nttienKID03/self-balancing-bike/README.md

## Design of a PID controller for a self-balancing two-wheeled vertical vehicle
Using PID controller theory and combining it with the MPU6050 sensor, control a two-wheeled vertical vehicle (bicycle model) to move in a self-balancing manner.

My Project: https://youtube.com/shorts/fzjEKal2ZSk

## Overview
This project focuses on  modeling and simulation of a self-balacing bike.  
The mechanical model of the robot was designed in SolidWorks and then integrated into MATLAB/Simulink using Simscape Multibody for dynamic simulation.

## Objectives
- Design a self-balacing bike mechanical structure
- Import the CAD model into MATLAB/Simulink
- Perform kinematic analysis of the robot

## Tools and Software
- SolidWorks – Mechanical design of the robot
- MATLAB – Mathematical modeling and calculations
- Simulink – System modeling and simulation
- Simscape Multibody – Multibody dynamic simulation
