nttienKID03/self-balancing-bike/report/NguyenTanTien.pdf

### BỘ GIÁO DỤC & ĐÀO TẠO

TRƢỜNG ĐẠI HỌC SƢ PHẠM KỸ THUẬT TP. HỒ CHÍ MINH

KHOA ĐIỆN – ĐIỆN TỬ

BỘ MÔN TỰ ĐỘNG ĐIỀU KHIỂN

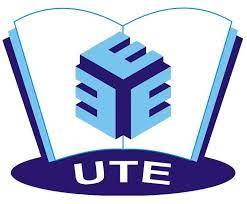
[picture p1: figure]

# BÁO CÁO MÔN HỌC

### Đồ án

### HỆ THỐNG ĐIỀU KHIỂN TỰ ĐỘNG

ĐỀ TÀI:
THIẾT KẾ BỘ ĐIỀU KHIỂN PID CHO XE HAI BÁNH DỌC TỰ CÂN BẰNG

GVHD: PGS. TS. Vũ Văn Phong SVTH: Nguyễn Tấn Tiến

MSSV: 21151171

Tp. Hồ Chí Minh, tháng 01 năm 2025

1

MỤC LỤC

2

3

PHỤ LỤC HÌNH ẢNH

4

PHỤ LỤC BẢNG

5

LỜI CẢM ƠN
Chúng em cũng xin chân thành cảm ơn các thầy cô giáo trong trường Đại

Học Sư Phạm Kỹ Thuật TP Hồ Chí Minh nói chung, các thầy cô trong Ngành

Kỹ Thuật Điều Khiển Và Tự Động Hóa nói riêng đã dạy cho chúng em kiến

thức về các môn đại cương cũng như các môn chuyên ngành, giúp em có đuợc

cơ sở lý thuyết vững vàng và tạo điều kiện giúp đỡ em trong suốt quá trình học

tập và ứng dụng để thực hiện đồ án môn học.

Đặc biệt, chúng em xin gửi lời cảm ơn chân thành đến thầy PGS. TS. Vũ

Văn Phong đã truyền đạt những kiến thức vô cùng hữu ích giúp chúng em hoàn

thành đồ án môn học lý thuyết hệ thống điều khiển tự động nâng cao. Thầy là

người đã luôn theo dõi, hướng dẫn, chỉ bảo rất tận tình những mặt thiếu sót

trong suốt quá trình nhóm thực hiện đề tài.

Trong đề tài chắc chắn sẽ còn nhiều lỗi cần khắc phục, chúng em rất

mong nhận được những đóng góp từ phía thầy và các bạn đọc để sửa chữa và

mở rộng vốn hiểu biết để hoàn thiện hơn cho những đề tài sau.

Sinh viên thực hiện

Nguyễn Tấn Tiến

6

NHẬN XÉT GIẢNG VIÊN

TP.HCM, tháng 01 năm 2025

Giảng viên

7

BỘ GIÁO DỤC VÀ ĐÀO TẠO

TRƢỜNG ĐẠI HỌC SƢ PHẠM KỸ THUẬT

THÀNH PHỐ HỒ CHÍ MINH

KHOA ĐIỆN-ĐIỆN TỬ

CỘNG HÒA XÃ HỘI CHỦ NGHĨA VIỆT NAM

Độc lập - Tự do – Hạnh phúc

DANH SÁCH THÀNH VIÊN THỰC HIỆN BÁO CÁO CUỐI KỲ

MÔN ĐỒ ÁN HỆ THỐNG ĐIỀU KHIỂN TỰ ĐỘNG

HỌC KỲ I NĂM HỌC 2024-2025

### 1. Giảng viên hƣớng dẫn: PGS. TS. Vũ Văn Phong

2. Tên đề tài: Thiết kế bộ điều khiển PID cho mô hình xe hai bánh dọc tự cân bằng.
4. Danh sách nhóm viết báo cáo cuối kỳ:
STT | HỌ VÀ TÊN | MSSV | HOÀN THÀNH | ĐIỂM SỐ
1 | Nguyễn Tấn Tiến | 21151171 | 100%

Nhận xét của giảng viên:

Tháng 01 năm 2025

Ký Tên

8

Chƣơng 1:
TỔNG QUAN

### 1.1. Đặt vấn đề

Trong bối cảnh phát triển mạnh mẽ của khoa học công nghệ, càng nhiều lĩnh vực thay đổi theo hướng hiện đại và tiện nghi. Trong số đó phải kể đến lĩnh vực giao thông. Mô hình xe tự cân bằng ngày càng đóng vai trò quan trọng từ giao thông cá nhân đến nghiên cứu các giải pháp di chuyển. Các bài toán liên quan đến xe hai bánh ngang song song đã được nghiên cứu nhiều và có nhiều thành công, song bài toán xe hai bánh dọc thẳng hàng vẫn còn nhiều hạn chế.

Hệ thống xe hai bánh tự cân bằng là một bài toán thách thức trong lĩnh vực điều khiển và động lực học. Đây là hệ thống có tính phi tuyến cao, chịu ảnh hường của nhiều yếu tố như trọng lực, ma sát,.. Để duy trì trạng thái cân bằng, hệ thống cần tích hợp chặt chẽ các thành phần: cảm biến đo góc nghiêng và gia tốc, thuật toán điều khiển và bộ truyền động. Trong đề tài này, bộ truyền động được nhóm sử dụng là bánh đà phản lực, mô phỏng cơ chế tự cân bằng thông qua chuyển động của cơ thể và tay lái khi con người điêu khiển xe đạp.

Sự độc đáo của xe hai bánh dọc không chỉ nằm ở yêu cầu kỹ thuật cao mà còn ở tiềm năng ứng dụng thực tiễn rộng rãi. Với kích thước nhỏ gọn, tính linh hoạt, xe hai bánh dọc tự cân bằng có thể trở thành giải pháp đột phá cho phương tiện di chuyển cá nhân trong đô thị đông đúc. Hơn nữa, hệ thống này còn là mô hình lý tưởng để nghiên cứu các phương pháp điều khiển hiện đại, áp dụng vào các lĩnh vực như robot tự hành, xe tự lái và các hệ thống tự động hóa thông minh.
Đề tài này sẽ tập trung vào thiết kế bộ điều khiển PID cho hệ phi tuyến xe đạp hai bánh dọc tự cân bằng.

### 1.2. Mục tiêu

- Áp dụng thành công bộ điều khiển PID trên mô hình xe đạp với hai bánh dọc tự cân bằng.

### 1.3. Giới hạn đề tài

- Đề tài tập trung nghiên cứu trên mô hình xe đạp với hai bánh dọc.
- Đề tài tập trung nghiên cứu bộ điều khiển PID cho điều khiển cân bằng.
- Đề tài hướng đến cân bằng hệ xe tại điểm cân bằng và đứng yên tại chỗ.

9

Chƣơng 2:
CƠ SỞ LÝ THUYẾT

### 2.1. Lý thuyết điều khiển PID

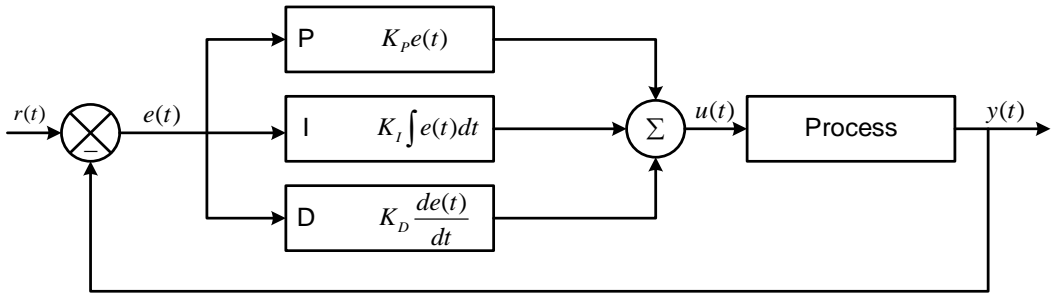
[picture p2: figure]
Process et() -

Hình 1: Cấu trúc bộ điều khiển PID.

Bộ điều khiển vi tích phân tỉ lệ (Proportional Integral Derivative – PID) bao gồm 3 khâu: khâu tỉ lệ (Proportional), khâu tích phân (Integrated) và khâu vi phân (Derivative). PID là một bộ điều khiển đơn giản, được sử dụng nhiều trong thực tế để điều khiển các hệ thống. Bộ điều khiển PID có khả năng điều chỉnh sai số thấp nhất có thể, tăng tốc độ đáp ứng, giảm độ vọt lố, hạn chế sự dao động. Cấu trúc bộ điều khiển PID được trình bày trong Hình 2.1. Có 3 thông số để điều chỉnh tín hiệu điều khiển: KP, KI
, KD
Trong đó, r(t) là giá trị đặt, y(t) là giá trị ngõ ra, giá trị ngõ ra được hồi tiếp về để so sánh với giá trị đặt r(t). Sự sai lệch giữa tín hiệu đặt và ngõ ra gọi là sai số e(t). Sai số được đưa vào bộ điều khiển PID sau đó xuất ra tín hiệu điều khiển u(t) điều khiển hệ thống Process.

0

( ) | ( ) | ( ) | ( )
| | t
p | I | D

d
u t | K e t | K e t dt K | e t
dt
= | + | + ò
(1)

Các thông số KP, KI

, KD là các thông số của bộ điều khiển PID. Nếu thông số này được lựa chọn phù hợp thì hệ thống sẽ hoạt động tốt và chính xác, có nghĩa là độ vọt lố thấp, thời gian xác lập nhanh và sai số xác lập thấp.

### 2.2. Con quay hồi chuyển_bánh xe phản lực

Con quay hồi chuyển là một đĩa quay được sử dụng điều khiển và ổn định các hệ thống như tàu vũ trụ và vệ tinh. Đối với đề tài xe đạp tự cân bằng, con quay hồi chuyển giúp duy trì thăng bằng cho xe. Con quay hồi chuyển có khối lượng tập trung ở viền ngoài của bánh đà, giúp tăng momen quán tính và tạo ra momen xoắn lớn hơn khi quay. Momen xoắn này sẽ phản ứng theo hướng ngược lại, giúp điều chỉnh và ổn định khi xe có xu hướng nghiêng ngã.

10

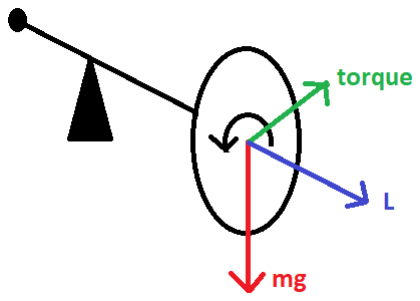
[picture p3: figure]

Hình 2: Mô tả nguyên lý hoạt động của con quay hồi chuyển.

### 2.3. Mô hình hóa hệ thống xe đạp tự cân bằng

### 2.3.1. Chuyển mô hình xe đạp về dạng con lắc ngƣợc

Giới hạn đề tài với xe đứng yên tại chỗ, khi đó trạng thái cân bằng của xe được duy trì thông qua điều khiển góc nghiêng. Mô tả toán học chỉ còn phụ thuộc vào góc nghiêng của xe, ta có mô tả vật lý như sau:

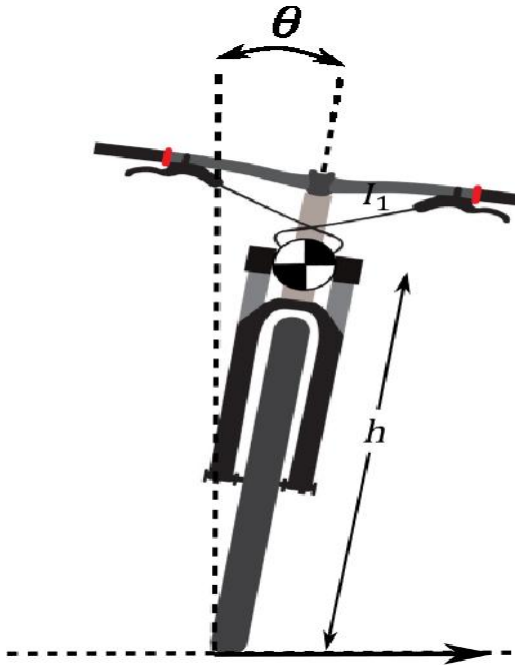
[picture p4: figure]

Hình 3: Mô tả vật lý hệ xe cân bằng đứng yên tại chỗ.

11

Ta thấy sự tương đồng với mô hình hệ con lắc ngược khi xét thân xe trên mặt phẳng thẳng đứng, trọng tâm ở điểm A như hình:

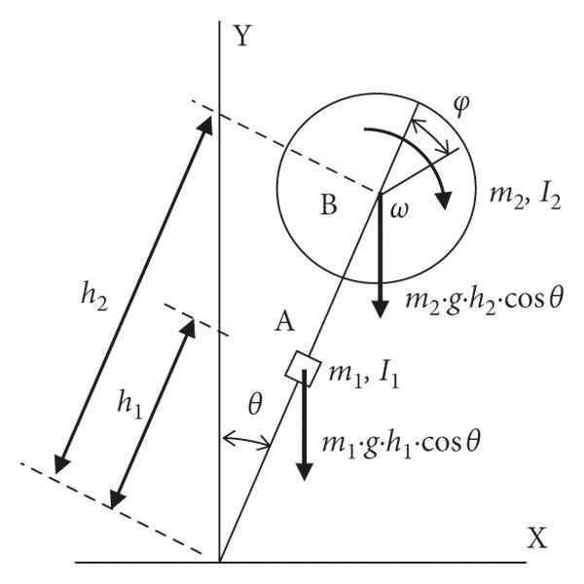
[picture p5: figure]

Hình 4: Chuyển đổi mô hình xe cân bằng về mô hình con lắc ngược.

### 2.3.2. Phân tích vật lý và toán học cho hệ thống

Bảng 2.2.2. Thông số hệ thống

Ký hiệu | Đơn vị | Mô tả
h 1 | m | Khoảng cách từ O đến trọng tâm A của xe.
h 2 | m | Khoảng cách từ O đến điểm đặt B của đĩa phản lực.
m1 | Kg | Khối lượng xe đạp.
m2 | Kg | Khối lượng đĩa phản lực.
θ | Rad | Góc lệch của thân xe đạp so với phương thẳng đứng.
φ | Rad | Góc xoay của đĩa phản lực.

12

I 1 | Kg.m² | Momen quán tính của xe đạp.
I 2 | Kg.m² | Momen quán tính của đĩa phản lực.
g | m/s² | Gia tốc trọng trường.
τ | Nm/A | Momen của động cơ DC.
V | Volt | Điện áp cấp cho động cơ.
K e | m | Hằng số momen động cơ.
Kt | Kg.m² | Hằng số moment xoắn động cơ.
ω m | Rad/s | Tốc độ góc động cơ.
L m | H | Giá trị cảm kháng cuộn cảm động cơ.
R m | Ω | Giá trị điện trở động cơ.
i | A | Dòng điện qua động cơ.

Mô hình toán học của hệ thống được lập từ việc áp dụng phương pháp lượng tử Lagrange:

,( | 1,2) i
i | i
d | L | L | i
dt | q | q

τ

æ | ö ∂ | ∂ ç | ÷ - | = | =
∂ | ∂ è | ø

(2)

Với L là phương trình Lagrange được xác định bởi:
L q q | K q q V q q ( , ) | ( , ) | ( , ) = | -
(3)

Trong đó K là tổng động năng và V là tổng thế năng của hệ.
i

τ

là tổng các lực

liên kết tác động vào hệ thống. Và
[ 1 | 2 ] [ | ]
T | T
q | q | q = | = θφ

là các thành phần liên
kết tạo nên hệ thống.

Ta có:

( | )
2 | 2 | 2 | 2
1 1 | 2 2 | 1 | 2 | 2 | 2
1 | 1
2 | 2
K | m h | m h | I | I | I | I = | + | + | + | + | + θ | θφ | φ

(4)

13

1 1 | 2 2 | 1 1 | 2 2 V | m h m h g | m h m h g = | + | ≈ | + ( | ) cos | ( | ) θ
(5)

Trong đó, xét trường hợp xe ở vị trí cân bằng ( θ

nhỏ vô cùng) thì
cos | 1, sin | . θ | θ θ ≈ | ≈

Qua đó ta tính được phương trình Lagrange như sau:
( | )
2 | 2 | 2 | 2
1 1 | 2 2 | 1 | 2 | 2 | 2 | 1 1 | 2 2
1 | 1 | ( | ) cos
2 | 2
L | m h | m h | I | I | I | I | m h m h g = | + | + + | + | + | - | + θ | θφ | φ | θ
(6)

Từ (2) và (6), suy ra:

2 | 2
1 1 | 2 2 | 1 | 2 | 2 | 1 1 | 2 2
| | | 2
( | ) | ( | ) | 0
( | )
m h | m h | I | I | I | m h | m h g
| | | I
θ | φ | θ
| | | | θ φ τ
ì | + | + | + | + | - | + | = í
î
| | | | + | =

(7)

Viết lại dưới dạng phương trình trạng thái với tín hiệu điều khiển là momen như sau:

2 | 2
0 | 1 0 0 | | 0
/ | 0 0 0 | | 1/
0 | 0 0 1 | | 0
/ | 0 0 0 | ( | ) / ( | )
ba | a
ba | a I | aI
θ | θ
θ | θ
τ
φ | φ
φ | φ
éù é | ù é ù é | ù êú ê | ú ê ú ê | ú
êú = | + ê | ú ê ú ê | ú êú ê | ú ê ú ê | ú êú ê | ú ê ú ê | ú êú ë | û ë û - | ë | û + ëû
(8)

Với:

2 | 2
1 1 | 2 2 | 1 | 1 1 | 2 2 a m h | m h | I | b | m h | m h g = | + | + | = | + , | ( | )

Tiếp theo, ta phân tích động cơ DC:

m | m | e | m
di V L | R i K
dt
= | + | + ω
(9)

Kit
τ =
(10)

Với giá trị cuộn cảm rất nhỏ so với điện trở, ta viết lại công thức (9) như sau:

V | R i K = | +
m | e | m ω
(11)

Ta xem như truyền tải giữa động cơ và bánh xe đạt 100%, khi đó:

ωφ m

=
(12)

Từ (10) , (11) và (12), ta được công thức tính momen động cơ như sau:

( | ) / K V K | R t | e | m τ | φ = | -
(13)

Từ (8) và (13), ta có hệ phương trình mô tả hệ thống như sau:

14

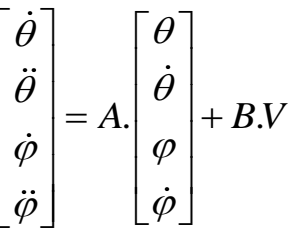
[picture p6: figure]

éù | éù êú | êú êú = | + êú êú | êú êú | êú êú ëû | ëû

(14)

Trong đó:

2 | 2
0 | 1 0 | 0
/ | 0 0 | ( | ) / ( | )
0 | 0 0 | 1
/ | 0 0 | ( | )( | ) / ( | )
t | e | m
t | e | m
b a | K K | aR
A
b a | a I | K K | aI R
é | ù
ê | ú
= ê | ú
ê | ú
ê | ú ë | û - | - + 2 | 2

0
/ ( )
0
( | ) | / ( | )
t | m
t | m
K | aR
B
a I K | aI R
é | ù
ê | ú
= ê | ú
ê | ú
ê | ú ë | û +

Với:

2 | 2
1 1 | 2 2 | 1 | 1 1 | 2 2 a m h | m h | I | b | m h m h g = | + | + | = | + , | ( | )

Các biến trạng thái:

1

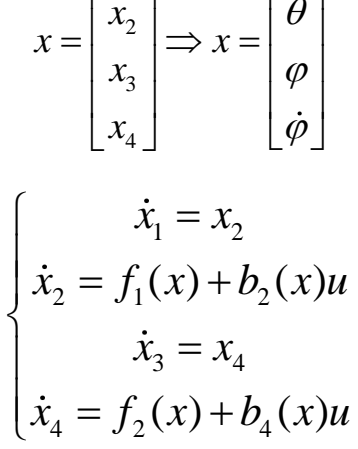
[picture p7: figure]

2

x
x

θ
θ
éù | éù
êú | êú

(15)

(16)

Với:

1 | 21 1 | 24 4 | 2 | 41 1 | 44 4 f x | a x | a x | f x | a x | a x ( ) | , | ( ) = | + | = | +

15

Chƣơng 3:
THIẾT KẾ HỆ THỐNG

### 3.1. Thiết kế mô hình

Một số chi tiết chính như sau:

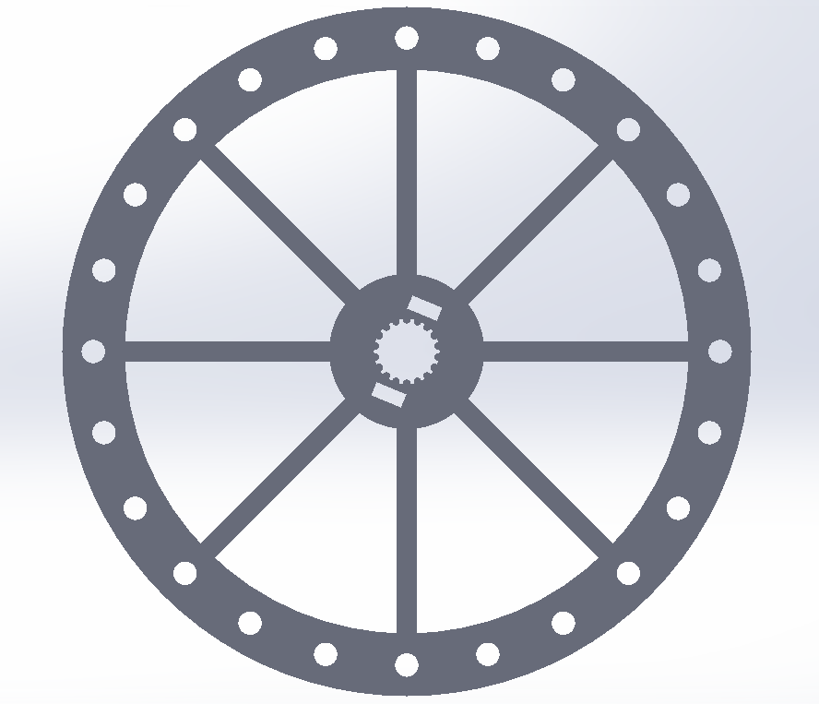
[picture p8: figure]

Hình 5: Bánh đà phản lực thiết kế trên Solidworks.

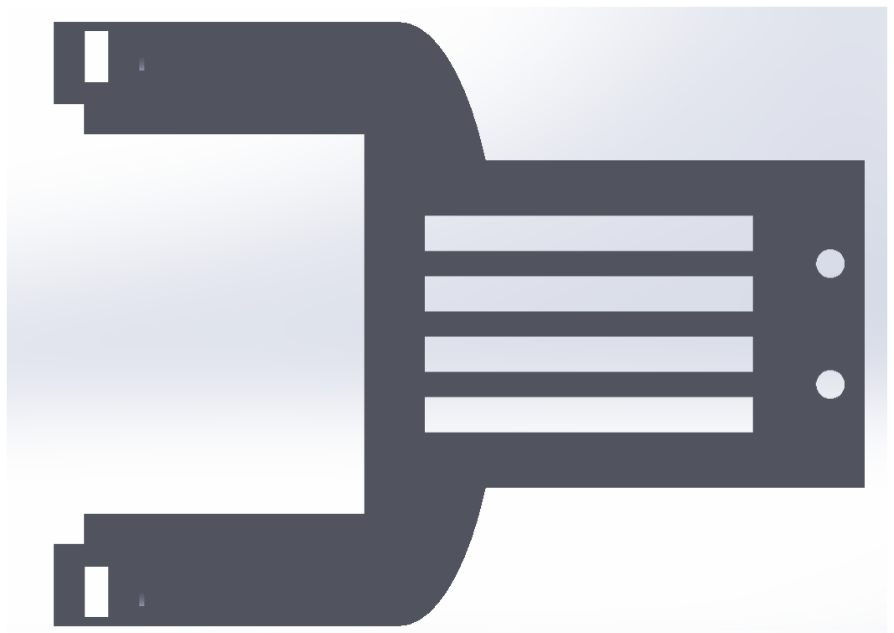
[picture p9: figure]

Hình 6: Phần thân trên.

16

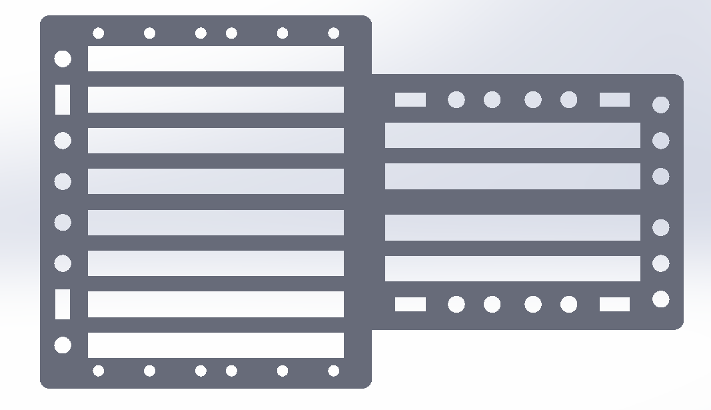
[picture p10: figure]

Hình 7: Phần thân dưới.

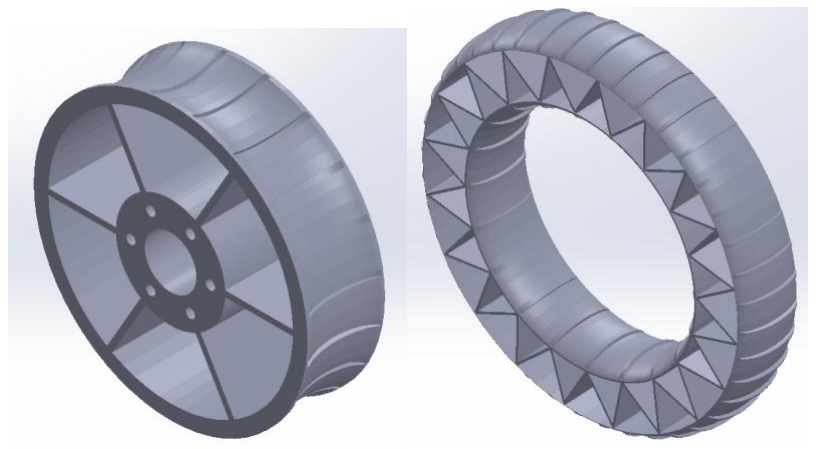
[picture p11: figure]

Hình 8: Bộ bánh sau.

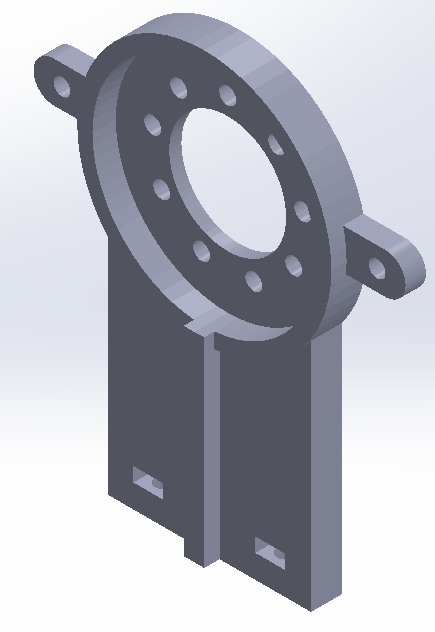
[picture p12: figure]

Hình 9: Trục gắn động cơ.

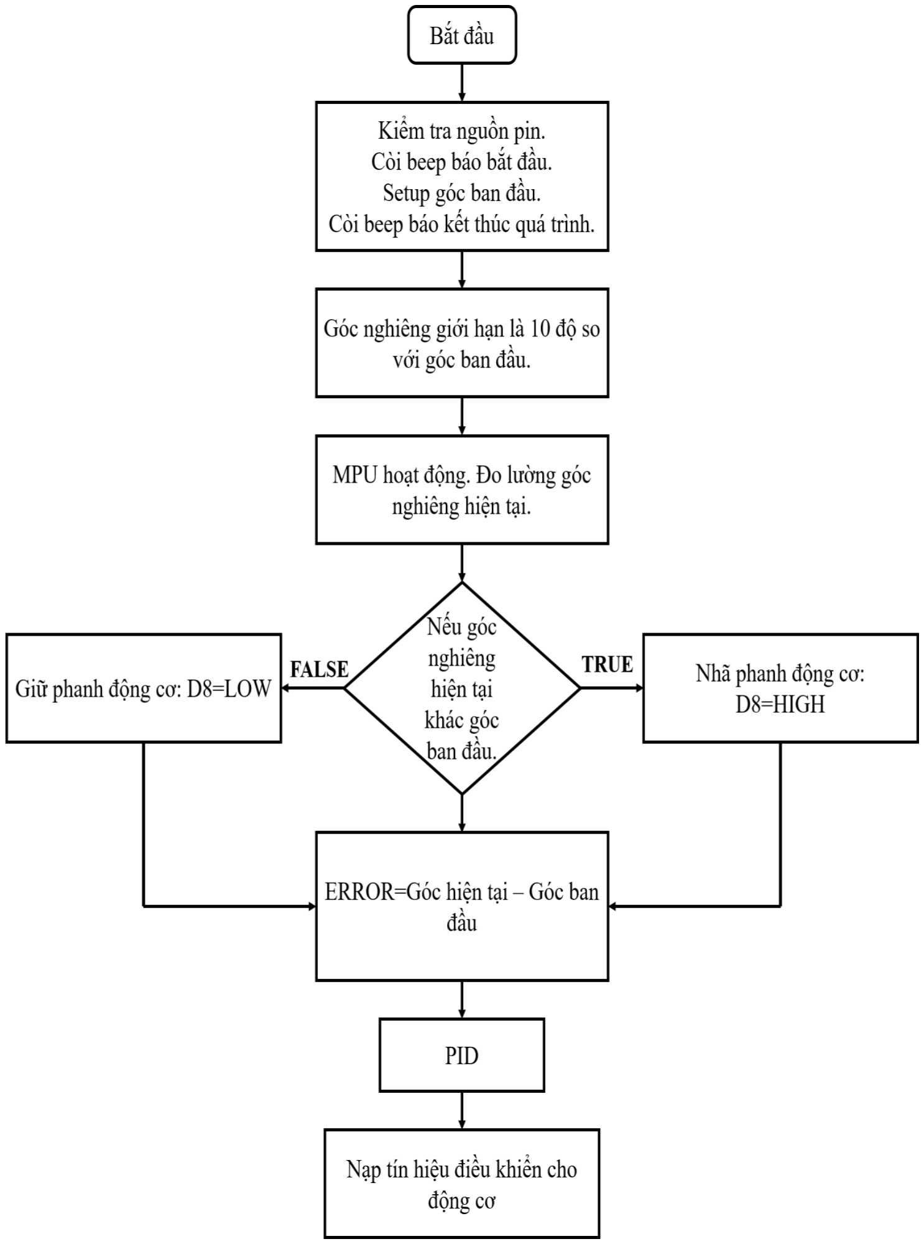
[picture p13: figure]

17

### 3.2. Thiết kế bộ điều khiển

### 3.2.1. Lƣu đồ giải thuật

Hình 10: Lưu đồ giải thuật điều khiển cho hệ xe tự cân bằng.

18

### 3.2.2. Tìm thông số PID bằng MATLAB Simulink

Bảng 3.2.2. Bảng thông số mô phỏng:

Ký hiệu | Đơn vị | Giá trị
h 1 | m | 0.06
h 2 | m | 0.12
m1 | Kg | 1
m2 | Kg | 0.3
I 1 | Kg.m² | 0.0048
I 2 | Kg.m² | 0.00108
g | m/s² | 9.81
K e | m | 0.0649
Kt | Kg.m² | 0.0649
R m | Ω | 5

Ta tiến hành mô phỏng hệ thống:

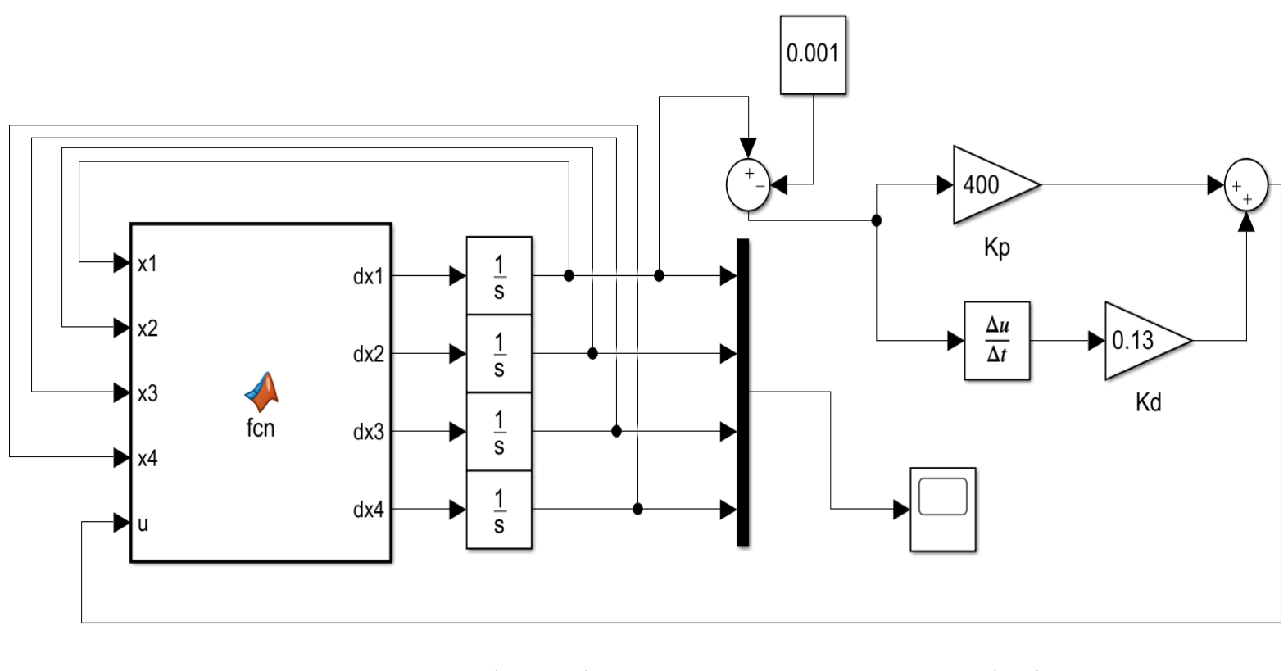
[picture p14: figure]

19

Hình 11: Mô phỏng hệ xe trên MATLAB Simulink.

Chương trình PTVP của hệ thống:

function [dx1,dx2,dx3,dx4] = fcn(x1,x2,x3,x4,u) m1=1;
m2=0.5;
h1=0.06;
h2=0.12;
I1=0.0048;
I2=0.002;
g=9.81;
Ke=0.0649;
Kt=0.0649;
Rm=5;
a=(m1*h1*h1+m2*h2*h2+I1);
b=(m1*h1+m2*h2)*g;
b2=(-Kt)/(a*Rm);
b4=((a+I2)*Kt)/(a*I2*Rm);
dx1=x2;
dx2=b/a*x1+((Kt*Ke)/(a*Rm))*x4+b2*u;
dx3=x4;
dx4=-b/a*x1-(a+I2)*(Kt*Ke)/(a*I2*Rm)*x4+b4*u; end
Ta chọn Kp=15 và Kd=0.13 ngẫu nhiên, thu được kết quả như sau:

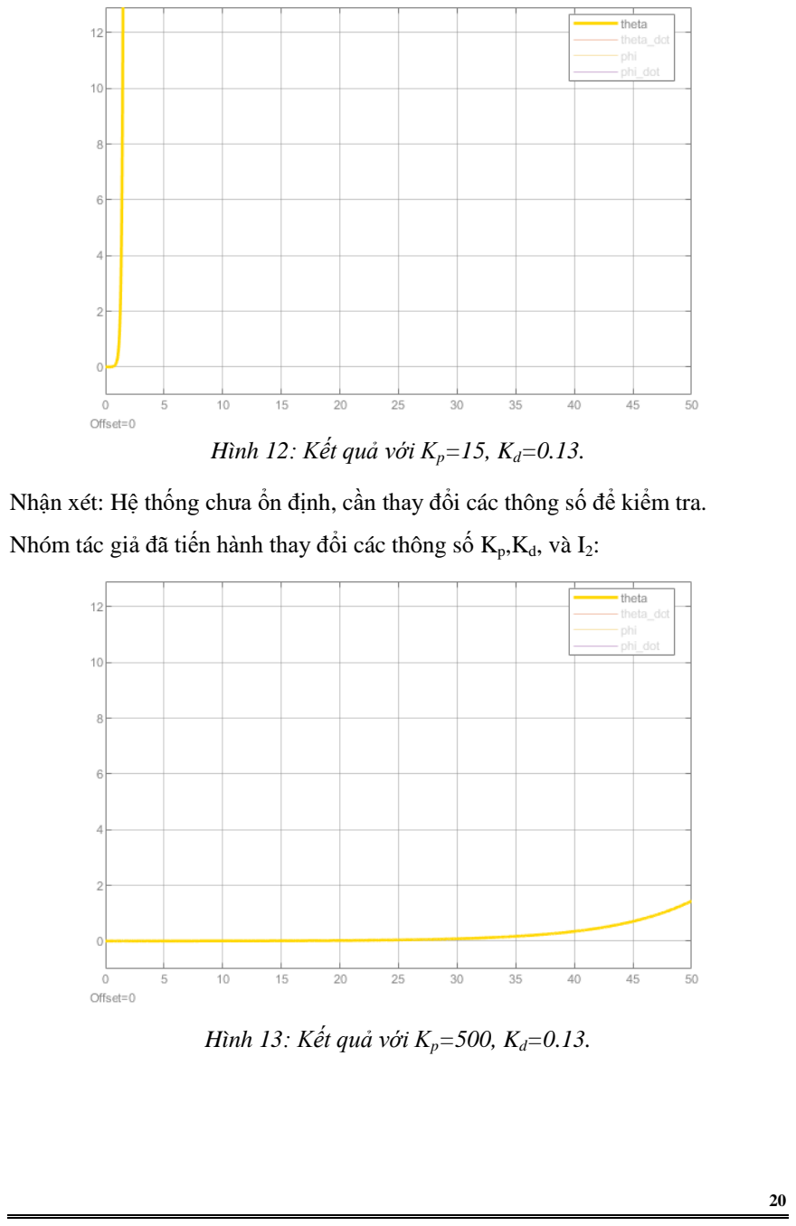
[picture p15: page 21]

20

Hình 12: Kết quả với Kp=15, Kd=0.13.

Nhận xét: Hệ thống chưa ổn định, cần thay đổi các thông số để kiểm tra.

Nhóm tác giả đã tiến hành thay đổi các thông số Kp,Kd, và I2:

Hình 13: Kết quả với Kp=500, Kd=0.13.

21

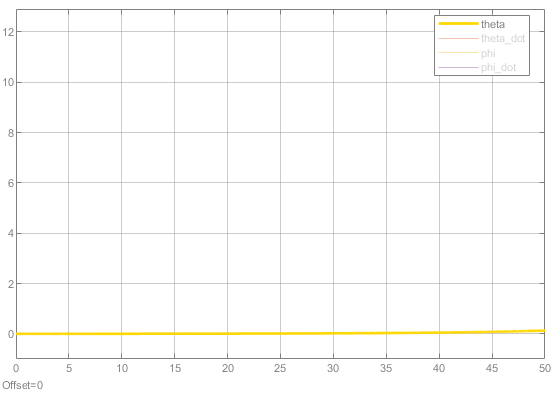
[picture p16: figure]

Hình 14: Kết quả với Kp=500, Kd=0.13, m2=0.5, I2=0.002.

Nhận xét: Cần thử sai nhiều lần với các thông số khác nhau để tìm ra bộ thông số ổn định hệ thống.

Chƣơng 4:
THI CÔNG HỆ THỐNG

### 4.1. Lựa chọn thiết bị

### 4.1.1. Vi điều khiển

- Tến thiết bị: Arduino Uno R3
- Giới thiệu chung: Arduino Uno R3 là một bo mạch vi điều khiển mã nguồn mở thuộc dòng Arduino phổ biến. Sử dụng vi xử lý Atmega328P, nó được thiết kế để đáp ứng nhiều ứng dụng học tập và nghiên cứu khác nhau.
- Lý do lựa chọn: Hệ thống có số lượng đường tín hiệu cảm biến và số lượng tín hiệu điều khiển ít, bên cạnh đó các tác vụ cần xử lý tương đối đơn giản và tốc độ xử lý không cần quá lớn. Do đó nhóm tác giả lựa chọn loại UNO R3 để phục vụ đủ nhu cầu sử dụng và tránh lãng phí.
- Một số thông số kỹ thuật chính:
- Tần số xung nhịp: 16MHz
- Điện áp đầu vào: 7-12V qua jack cấm; 5V qua cổng USB
- Số chân I/O Digital: 14 chân (6 chân PWM)
- Số chân đầu vào Analog: 6 chân

22

- Giao tiếp: UART, SPI, I2C
- Trọng lượng: 25g

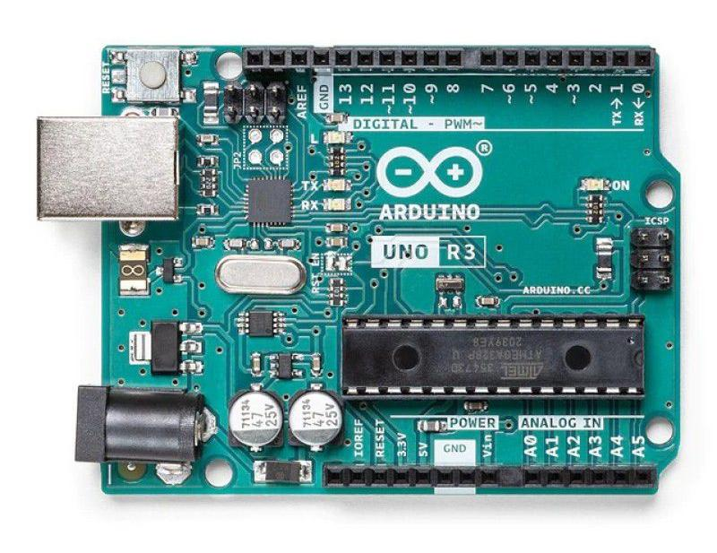
[picture p17: figure]

Hình 15: Board vi điều khiển Arduino UNO R3

### 4.1.2. Cảm biến

- Tên thiết bị: MPU6050
- Giới thiệu chung: MPU6050 là cảm biến IMU tích hợp, gồm gia tốc kế 3 trục và con quay hồi chuyển 3 trục, cho phép đo gia tốc tuyến tính và tốc độ góc theo ba trục X, Y, Z. Bên cạnh đó MPU6050 còn tích hợp bộ xử lý chuyển động kỹ thuật số (DMP) để xử lý dữ liệu chuyển động, giúp tính toán góc nghiêng.
- Lý do lựa chọn: Hệ thống cần cảm biến để đo lường góc nghiêng cho mục đích giữ thăng bằng và đo lường chuyển động nếu xe di chuyển, mà MPU6050 được tích hợp cả gia tốc kế và con quay hồi chuyển, bên cạnh đó còn được hỗ trợ giao tiếp I2C.
- Một số thông số kỹ thuật chính:
- Tần số lấy mẫu: 1kHz
- Điện áp hoạt động: 3.3-5V
- Trọng lượng: 1-2g
- Độ nhạy gia tốc kế: 2g
- Độ nhạy con quay hồi chuyển: 250o /s

23

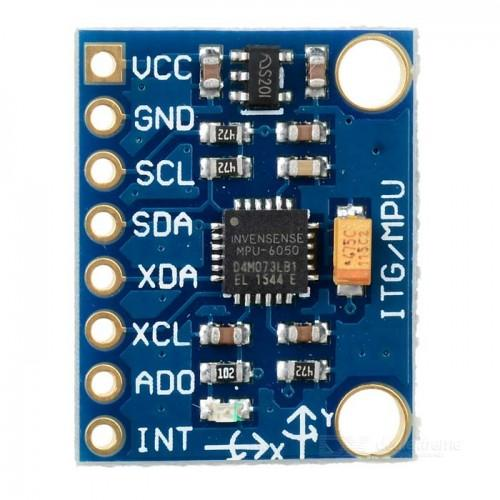
[picture p18: figure]

Hình 16: Cảm biến MPU6050.

### 4.1.3. Động cơ DC

- Tên thiết bị: Nidec 24H404H070
- Giới thiệu chung: Động cơ DC Nidec 24H404H070 là một loại động cơ một chiều được sản xuất bởi Nidec, chuyên sử dụng trong các ứng dụng yêu cầu khả năng vận hành mạnh mẽ và ổn định.
- Lý do lựa chọn: Động cơ DC Nidec 24H404H070 được lựa chọn cho xe đạp tự cân bằng vì khả năng cung cấp lực momen lớn, điều khiển dễ dàng qua PWM.
- Một số thông số kỹ thuật chính:
- Điện áp hoạt động: 12V
- Momen cực đại: 1.45 N.m
- Trọng lượng: 120g

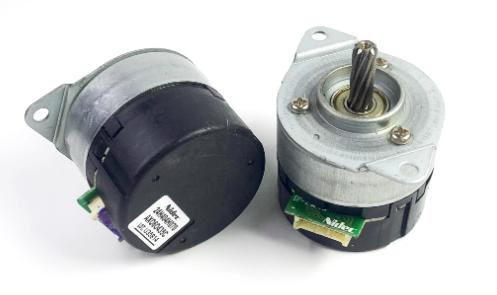
[picture p19: figure]

Hình 17: Động cơ DC nidec 24h404h070.

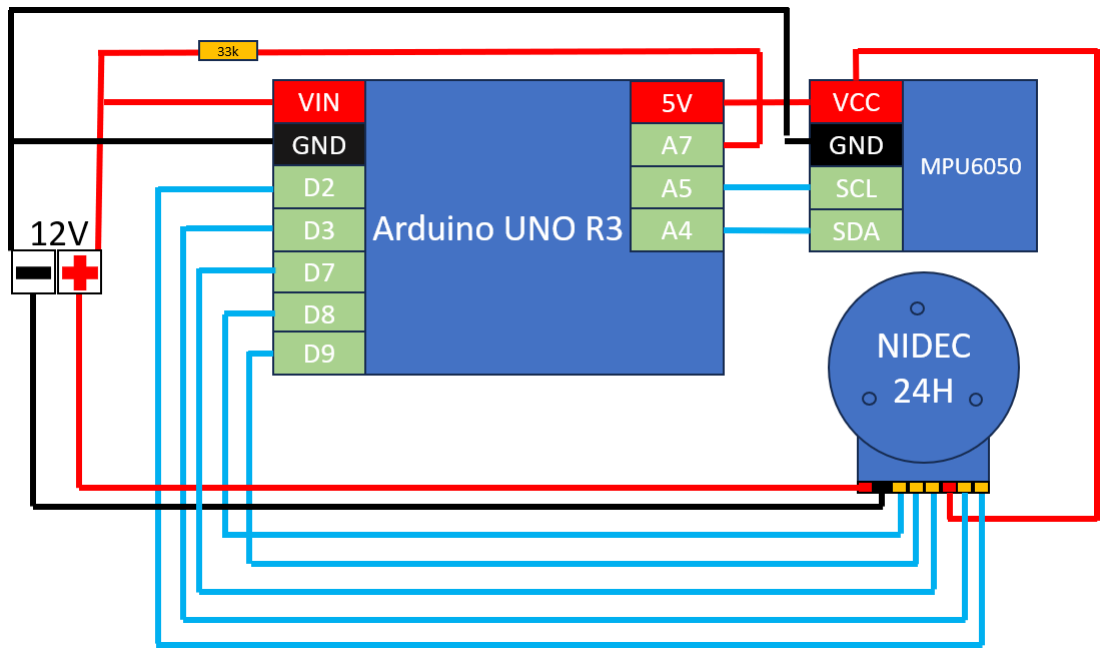
[picture p20: figure]

24

### 4.2. Lắp ráp mô hình

### 4.2.1. Phần cứng hệ thống

- Sơ đồ kết nối:

Hình 18: Sơ đồ kết nối mạch điện.

### 4.2.2. Phần mềm hệ thống

- Ta tiến hành nạp code cho vi điều khiển thông qua arduino, với cấu trúc chương trình bám sát lưu đồ giải thuật.

Chương trình chính điều khiển hệ thống:

#include <Wire.h>

#include <MPU6050_tockn.h>

MPU6050 mpu6050(Wire);
#define PWM_1 | 9

#define DIR_1 | 7

#define ENC_1 | 2

#define ENC_2 | 3

#define BRAKE | 8

#define BUZZER | 12

#define VBAT | A7

bool vertical = false;
bool calibrating = false;
bool calibrated = false;
float loop_time = 3;
float e=0,e_d=0,e_i=0,RoAngle, RoAngle_offset,RoAngle_sum,preRoAngle; float Kp=30;

25

float Kd = 0.13;
volatile int motor_speed=0, enc_count = 0;
volatile byte pos;
int bat_divider = 58; // this value needs to be adjusted to measure the battery voltage correctly
long currentT, previousT_1, previousT_2 = 0;
void writeTo(byte device, byte address, byte value) { Wire.beginTransmission(device); Wire.write(address);
Wire.write(value);
Wire.endTransmission(true);
}
void beep() {
digitalWrite(BUZZER, HIGH); delay(70);
digitalWrite(BUZZER, LOW); delay(80);
}
void Motor1_control(int sp) {
if (sp > 0) digitalWrite(DIR_1, LOW); else digitalWrite(DIR_1, HIGH); analogWrite(PWM_1, 255 - abs(sp)); }
void angle_calc() {
mpu6050.update();
RoAngle=mpu6050.getAngleX();
if (abs(RoAngle) > 10) vertical = false;
if (abs(RoAngle) < 0.8) vertical = true;
if (abs(RoAngle) >= 30) {Motor1_control(0); digitalWrite(DIR_1, LOW); } }
void angle_setup() {
Wire.begin();
delay(100);
for (int i = 0; i < 1024; i++) { angle_calc();
RoAngle_sum += RoAngle;
}
RoAngle_offset = RoAngle_sum/1024;
beep();
beep();
Serial.print("Robot angle offset: "); Serial.println(RoAngle_offset); calibrated = true;
}
void battVoltage(double voltage) {
if (voltage > 8 && voltage <= 9.5) { digitalWrite(BUZZER, HIGH);
} else {
digitalWrite(BUZZER, LOW);

26

}
}
void ENC_READ() {
byte cur = (!digitalRead(ENC_1) << 1) + !digitalRead(ENC_2); byte old = pos & B00000011;
byte dir = (pos & B00110000) >> 4;
if (cur == 3) cur = 2;
else if (cur == 2) cur = 3;
if (cur != old) {
if (dir == 0) {
if (cur == 1 || cur == 3) dir = cur;
} else {
if (cur == 0) {
if (dir == 1 && old == 3) enc_count--; else if (dir == 3 && old == 1) enc_count++; dir = 0;
}
}
pos = (dir << 4) + (old << 2) + cur; }
}
void setup() {
Serial.begin(115200);
Wire.begin();
mpu6050.begin();
mpu6050.calcGyroOffsets(true); TCCR1A = 0b00000001;
TCCR1B = 0b00001010;
pinMode(DIR_1, OUTPUT);
pinMode(BRAKE, OUTPUT);
pinMode(BUZZER, OUTPUT);
pinMode(ENC_1, INPUT);
pinMode(ENC_2, INPUT);
Motor1_control(0);
attachInterrupt(0, ENC_READ, CHANGE); attachInterrupt(1, ENC_READ, CHANGE); beep();
angle_setup();
delay(1000);
}
void loop() {
currentT = millis();
if (currentT - previousT_1 >= loop_time) { angle_calc();
motor_speed = -enc_count;
enc_count = 0;
if (vertical && calibrated && !calibrating) { digitalWrite(BRAKE, HIGH);

27

e=RoAngle-RoAngle_offset;
e_d=(RoAngle-preRoAngle)/0.001; e_i=e_i+e*0.001;
int pwm = constrain(Kp*e + Kd*e_d , -255, 255); Motor1_control(-pwm);
previousT_1 = currentT;
preRoAngle = RoAngle;
}
if (currentT - previousT_2 >= 2000) { battVoltage((double)analogRead(VBAT) / bat_divider);
if (!calibrated && !calibrating) {
Serial.println("first you need to calibrate the balancing point..."); }
previousT_2 = currentT;
}
}
}

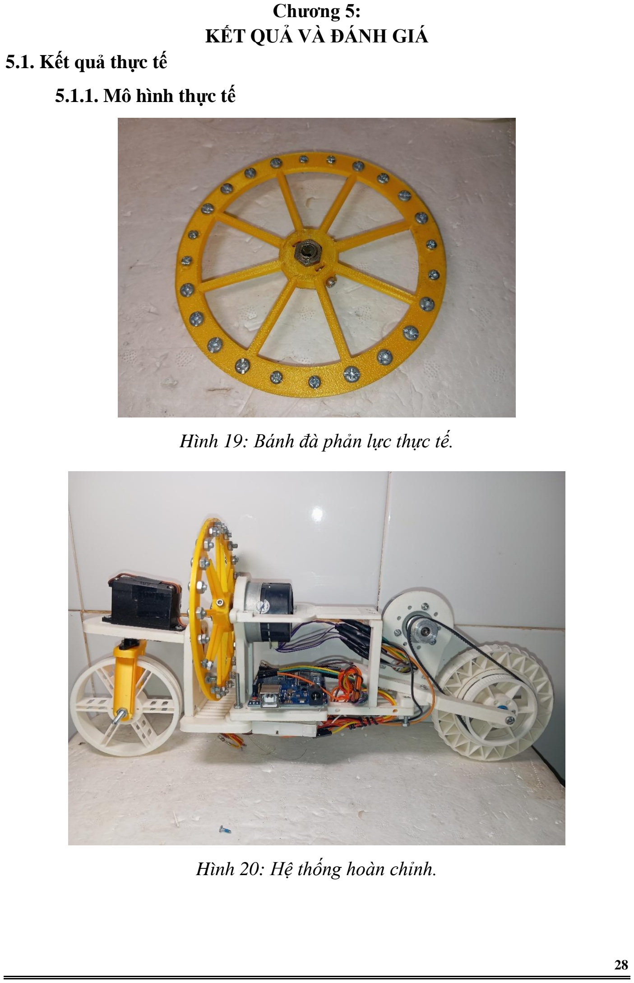
[picture p21: page 29]

28

Chƣơng 5:
KẾT QUẢ VÀ ĐÁNH GIÁ

### 5.1. Kết quả thực tế

### 5.1.1. Mô hình thực tế

Hình 19: Bánh đà phản lực thực tế.

Hình 20: Hệ thống hoàn chỉnh.

29

### 5.1.2. Chất lƣợng điều khiển thực tế

Trong quá trình thiết kế, phần cơ khí chưa được chính xác, dẫn đến khó khăn trong việc đo đạt các thông số để điều khiển hệ thống.

Nhóm tác giả nhận thấy, sau khi thử sai, bộ điều khiển PID hoạt động có thể duy trì trạng thái thăng bằng của xe, nhưng không được lâu dài.

Chất lượng hoạt động phụ thuộc nhiều vào việc bố trí các linh kiện trên thân xe sao cho cân đối, trọng tâm đặt gần nhất với trọng tâm mong muốn.

### 5.2. Đánh giá

Nhóm tác giả đã áp dụng thành công bộ điều khiển PID cho hệ xe đạp đứng yên tại chỗ tự cân bằng.

Trọng lượng và thông số PID cần được kiểm tra để tương thích với nhau, không phải momen bánh đà càng lớn thì càng dễ cân bằng, điều đó đã được nhóm tác giả thử sai và rút ra.
Trong quá trình cải tiến, nhóm tác giả cần thiết kế bánh đà phản lực có momen phù hợp để điều khiển. Đồng thời kết hợp khả năng di chuyển theo trục thẳng cho xe.

30

TÀI LIỆU THAM KHẢO
1. Huỳnh, H. T. (2006). Hệ thống điều khiển thông minh. TP. Hồ Chí Minh:

Đại học quốc gia TP. Hồ Chí Minh.

2. Nguyễn, T. T. (2014). Giáo trình kỹ thuật robot. TP. Hồ Chí Minh: Đại

học quốc gia TP. Hồ Chí Minh.

3. Nguyễn, H. P. (2009). Lý thuyết điều khiển hiện đại. TP. Hồ Chí Minh:

Đại học quốc gia TP. Hồ Chí Minh.
